westonb/plasma_tweeter/plasma_modulator.kicad_pcb

## KiCad design plasma_modulator.kicad_pcb (2015-02-10)

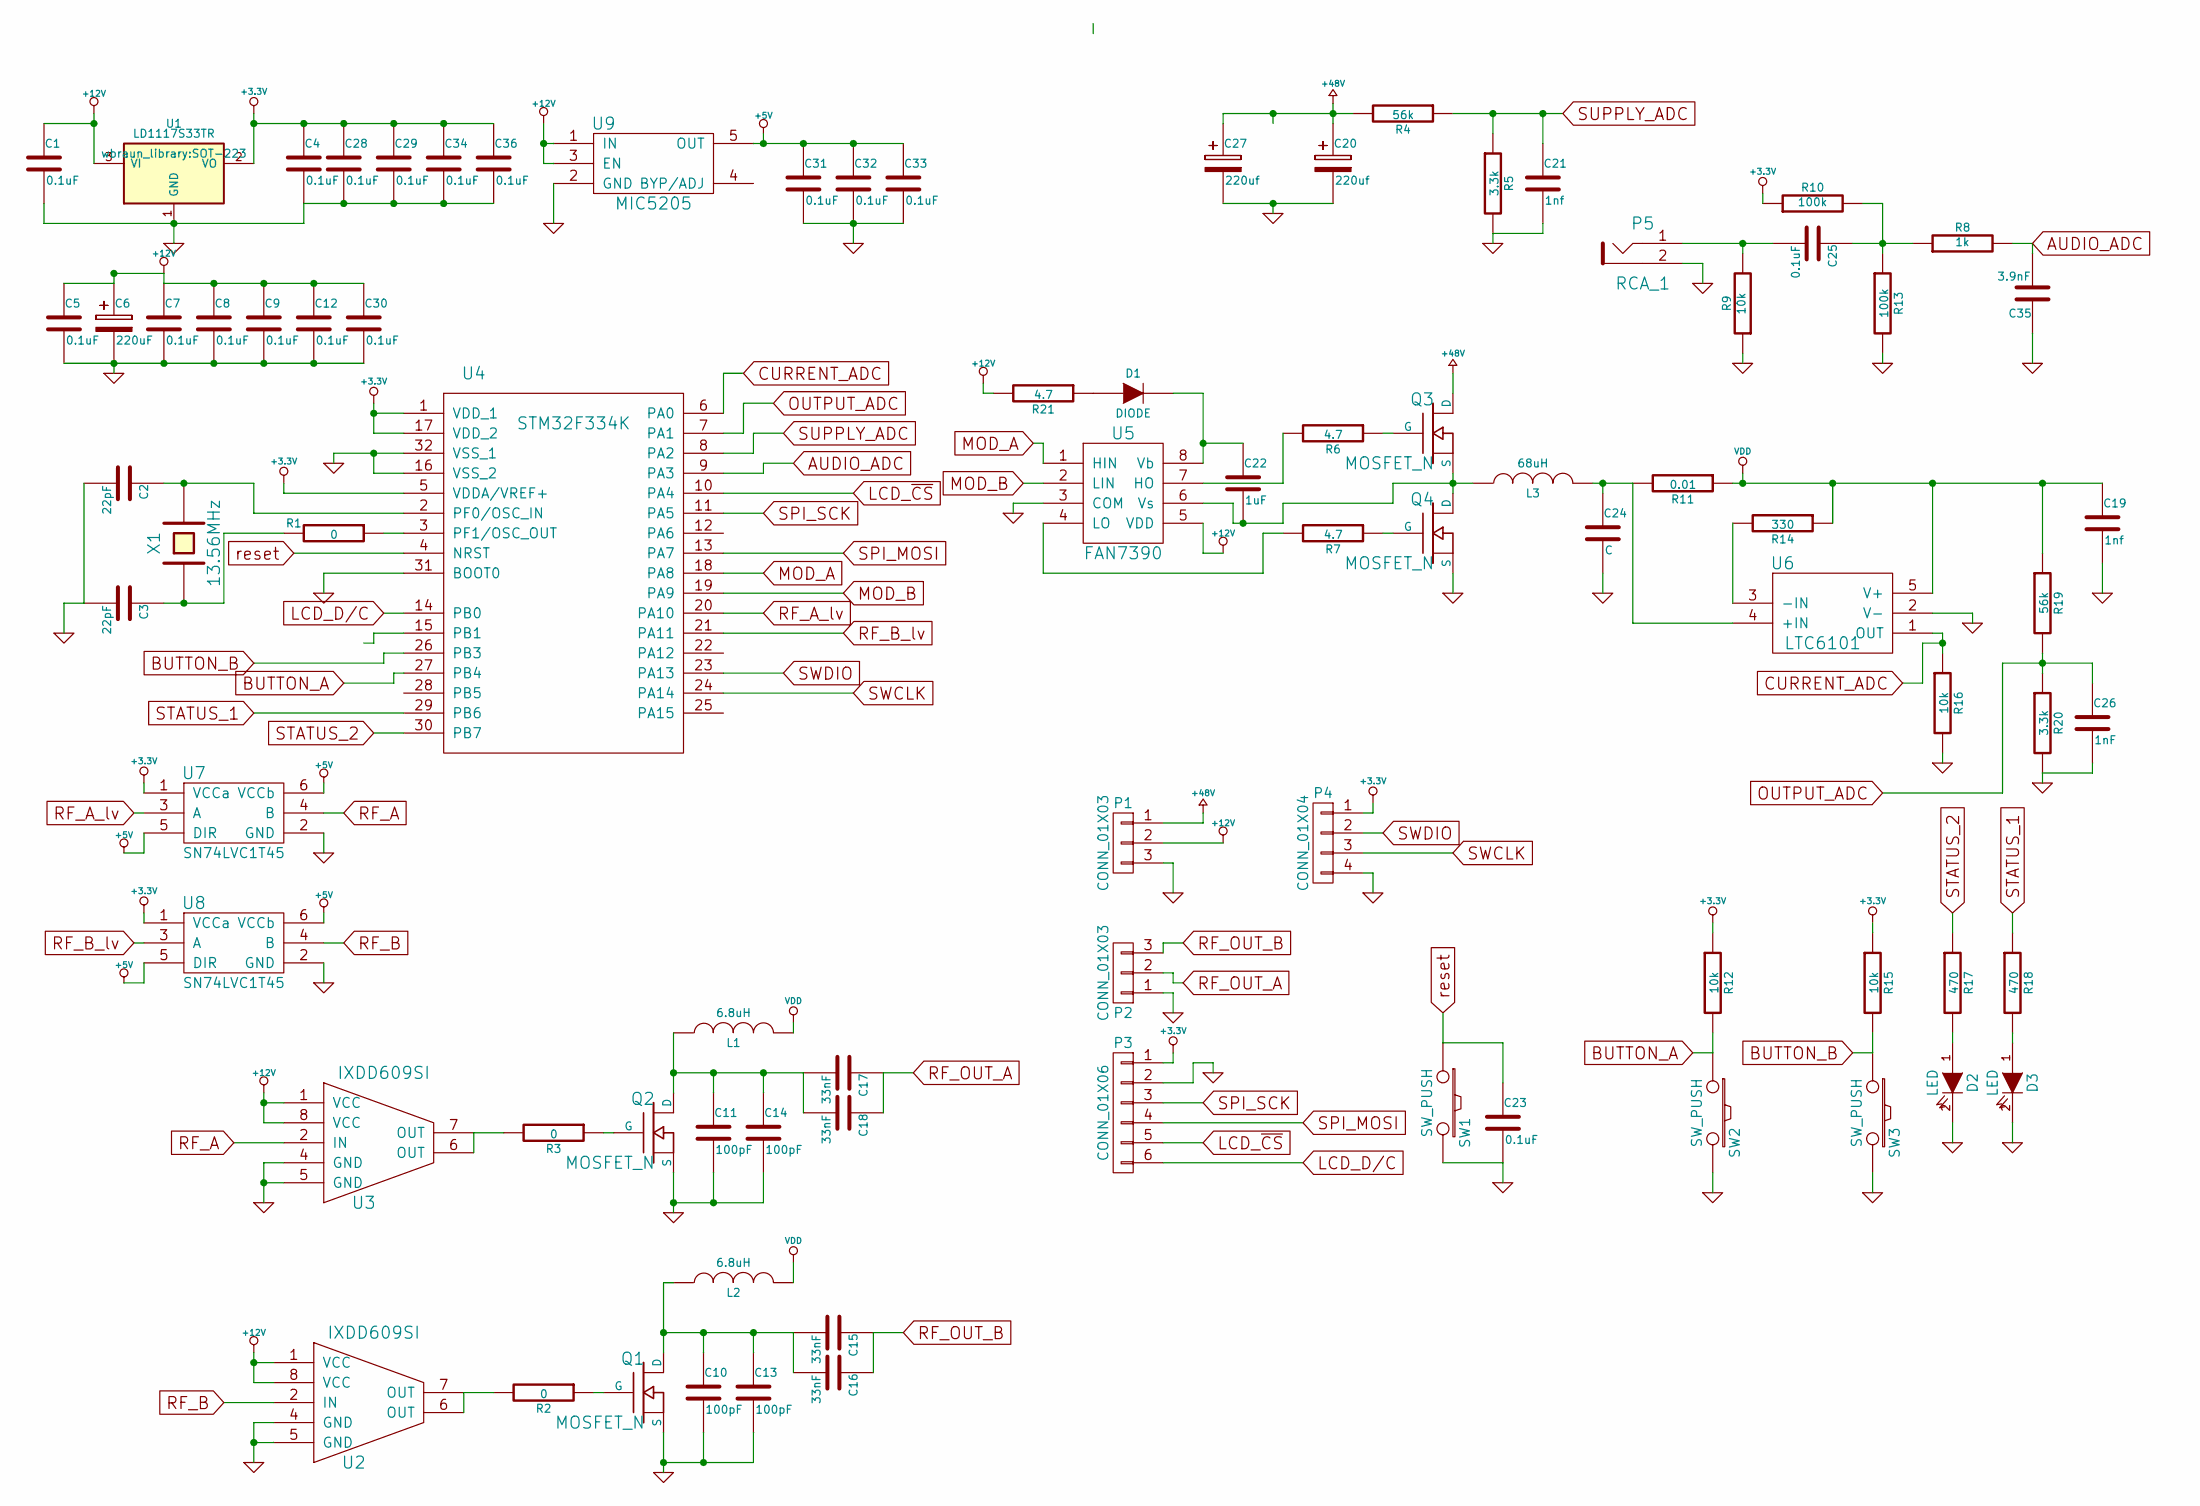
[picture p1: schematic plasma_modulator.sch]

Parts:
C1, C4, C5, C7, C8, C9, C12, C23, C25, C28, C29, C30, C31, C32, C33, C34, C36: 0.1uF; SMD-0805
C2, C3: 22pF; SMD-0805
C6: 220uF; Capacitor8x13RM3.8
C10, C11, C13, C14: 100pF; C_1206
C15, C16, C17, C18: 33nF; C_1206
C19: 1nf; C_1206
C20, C27: 220uf; Capacitor10x16RM5
C21: 1nf; SMD-0805
C22: 1uF; SMD-0805
C24: C; Capacitor18x9x15mmRM15
C26: 1nF; SMD-0805
C35: 3.9nF; SMD-0805
D1: DIODE; SOD-323
D2, D3: LED; LED-0805
L1, L2: 6.8uH; MSS1278
L3: 68uH; MSS1583
P1, P2: CONN_01X03; terminalBlock-5mm-3
P3: CONN_01X06; Pin_Header_Straight_1x06
P4: CONN_01X04; Pin_Header_Straight_1x04
P5: RCA_1; RCA
Q1, Q2, Q3, Q4: MOSFET_N; TO-220_FET-GDS_Vertical_LargePads
R1, R2, R3: 0; SMD-0805
R4, R19: 56k; SMD-0805
R5, R20: 3.3k; SMD-0805
R6, R7, R21: 4.7; SMD-0805
R8: 1k; SMD-0805
R9, R12, R15, R16: 10k; SMD-0805
R10, R13: 100k; SMD-0805
R11: 0.01; R_1206
R14: 330; SMD-0805
R17, R18: 470; SMD-0805
SW1, SW2, SW3: SW_PUSH; button-5mm
U1: LD1117S33TR; SOT-223
U2, U3: IXDD609SI; SOIC-8_power
U4: STM32F334K; LQFP-32_7x7mm_Pitch0.8mm
U5: FAN7390; SOIC-8_3.9x4.9mm_Pitch1.27mm
U6: LTC6101; TSOT-23
U7, U8: SN74LVC1T45; SOT-23-6
U9: MIC5205; SOT-23-5
X1: 13.56MHz; 4-SMD

Connections:
+3.3V: C4.1, C28.1, C29.1, C34.1, C36.1, P3.1, P4.1, R10.1, R12.1, R15.1, U1.2 (VO), U4.1 (VDD_1), U4.5 (VDDA/VREF+), U4.17 (VDD_2), U7.1 (VCCa), U8.1 (VCCa)
+5V: C31.1, C32.1, C33.1, U7.5 (DIR), U7.6 (VCCb), U8.5 (DIR), U8.6 (VCCb), U9.5 (OUT)
+12V: C1.1, C5.1, C6.1, C7.1, C8.1, C9.1, C12.1, C30.1, P1.2, R21.2, U1.3 (VI), U2.1 (VCC), U2.8 (VCC), U3.1 (VCC), U3.8 (VCC), U5.5 (VDD), U9.1 (IN), U9.3 (EN)
+48V: C20.1, C27.1, P1.1, Q3.D, R4.2
AUDIO_ADC: C35.2, R8.2, U4.9 (PA3)
BUTTON_A: R12.2, SW2.1, U4.27 (PB4)
BUTTON_B: R15.2, SW3.1, U4.26 (PB3)
CURRENT_ADC: R16.1, U4.6 (PA0), U6.1 (OUT)
GND: C1.2, C2.2, C3.2, C4.2, C5.2, C6.2, C7.2, C8.2, C9.2, C10.2, C11.2, C12.2, C13.2, C14.2, C19.2, C20.2, C21.2, C23.2, C24.2, C26.2, C27.2, C28.2, C29.2, C30.2, C31.2, C32.2, C33.2, C34.2, C35.1, C36.2, D2.2 (K), D3.2 (K), P1.3, P2.1, P3.2, P4.4, P5.2, Q1.S, Q2.S, Q4.S, R5.2, R9.1, R13.2, R16.2, R20.2, SW1.2, SW2.2, SW3.2, U1.1 (GND), U2.4 (GND), U2.5 (GND), U2.9 (PAD), U3.4 (GND), U3.5 (GND), U3.9 (PAD), U4.16 (VSS_2), U4.31 (BOOT0), U4.32 (VSS_1), U5.3 (COM), U6.2 (V-), U7.2 (GND), U8.2 (GND), U9.2 (GND)
LCD_D/C: P3.6, U4.14 (PB0)
LCD_~CS~: P3.5, U4.10 (PA4)
MOD_A: U4.18 (PA8), U5.1 (HIN)
MOD_B: U4.19 (PA9), U5.2 (LIN)
unnamed: C2.1, U4.2 (PF0/OSC_IN), X1.2
unnamed: C3.1, R1.2, X1.1
unnamed: C10.1, C13.1, C15.2, C16.2, L2.1, Q1.D
unnamed: C11.1, C14.1, C17.2, C18.2, L1.1, Q2.D
unnamed: C22.1, D1.2 (K), U5.8 (Vb)
unnamed: C22.2, L3.1, Q3.S, Q4.D, U5.6 (Vs)
unnamed: C24.1, L3.2, R11.2, U6.4 (+IN)
unnamed: C25.1, R8.1, R10.2, R13.1
unnamed: C25.2, P5.1, R9.2
unnamed: D1.1 (A), R21.1
unnamed: D2.1 (A), R17.2
unnamed: D3.1 (A), R18.2
unnamed: Q1.G, R2.1
unnamed: Q2.G, R3.1
unnamed: Q3.G, R6.1
unnamed: Q4.G, R7.1
unnamed: R1.1, U4.3 (PF1/OSC_OUT)
unnamed: R2.2, U2.6 (OUT), U2.7 (OUT)
unnamed: R3.2, U3.6 (OUT), U3.7 (OUT)
unnamed: R6.2, U5.7 (HO)
unnamed: R7.2, U5.4 (LO)
unnamed: R14.2, U6.3 (-IN)
OUTPUT_ADC: C26.1, R19.2, R20.1, U4.7 (PA1)
RF_A: U3.2 (IN), U7.4 (B)
RF_A_lv: U4.20 (PA10), U7.3 (A)
RF_B: U2.2 (IN), U8.4 (B)
RF_B_lv: U4.21 (PA11), U8.3 (A)
RF_OUT_A: C17.1, C18.1, P2.2
RF_OUT_B: C15.1, C16.1, P2.3
SPI_MOSI: P3.4, U4.13 (PA7)
SPI_SCK: P3.3, U4.11 (PA5)
STATUS_1: R18.1, U4.29 (PB6)
STATUS_2: R17.1, U4.30 (PB7)
SUPPLY_ADC: C21.1, R4.1, R5.1, U4.8 (PA2)
SWCLK: P4.3, U4.24 (PA14)
SWDIO: P4.2, U4.23 (PA13)
VDD: C19.1, L1.2, L2.2, R11.1, R14.1, R19.1, U6.5 (V+)
reset: C23.1, SW1.1, U4.4 (NRST)

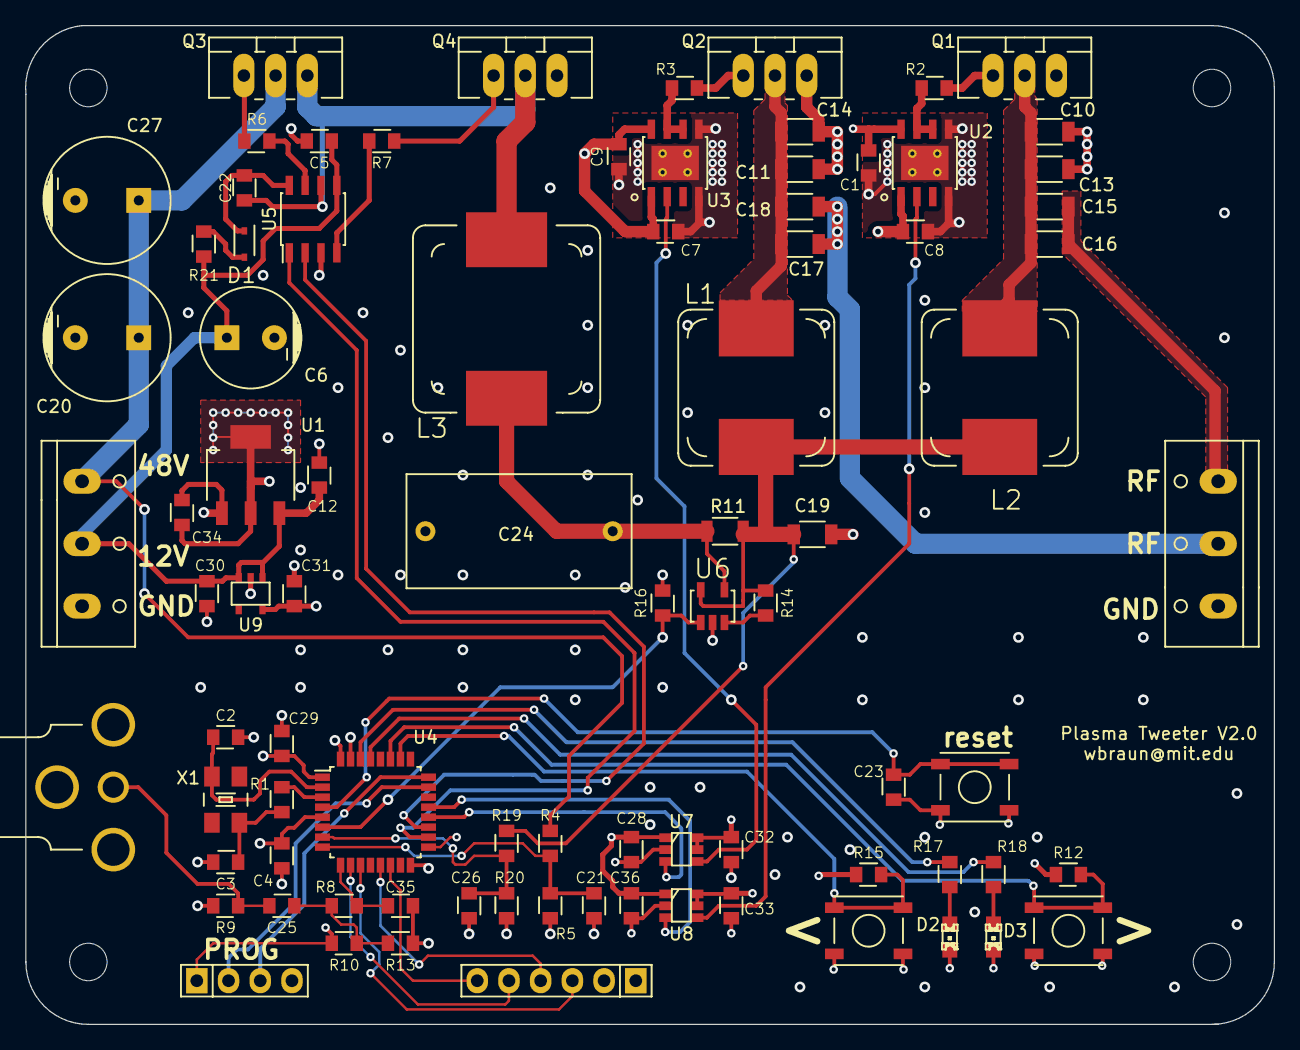
[picture p2: board plasma_modulator.kicad_pcb from above]

Board: 4 copper layers, 100.0 x 80.0 mm, 89 parts (0 on the bottom side), 51 nets.

Other parts of the board:
MountingHole_3mm, MountingHole_3mm#2, MountingHole_3mm#3, MountingHole_3mm#4: VAL**; MountingHole_3mm
