westonb/plasma_tweeter/(threads)

Thread 1 (2015-03-05):

Component Footprints

westonb, 2015-03-05:
C24 needs larger diameter PTH
push switches need longer pads
terminal block outline is wrong. It is wider/narrower than what is on silkscreen and overhangs board

Closed 2018-10-02.
