westonb/plasma_tweeter/(commit log)

2015-02-06 first commit!
    [plasma_modulator.kicad_pcb, plasma_modulator.sch]
2015-02-07 draft of component layout
    [plasma_modulator.kicad_pcb, plasma_modulator.sch]
2015-02-07 final component placement
    [plasma_modulator.kicad_pcb, plasma_modulator.sch]
2015-02-09 PCB ready for fab
    [plasma_modulator.kicad_pcb, plasma_modulator.sch]
2015-02-10 pcb sent to fab
    [plasma_modulator.kicad_pcb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]
